Thyme-git/SeedClass_Embeded_Course/(list of files, drawings)

Other design files:
pcb_design.epro
